pabloramesc/GimbalPlatform/pictures/3d_model.png

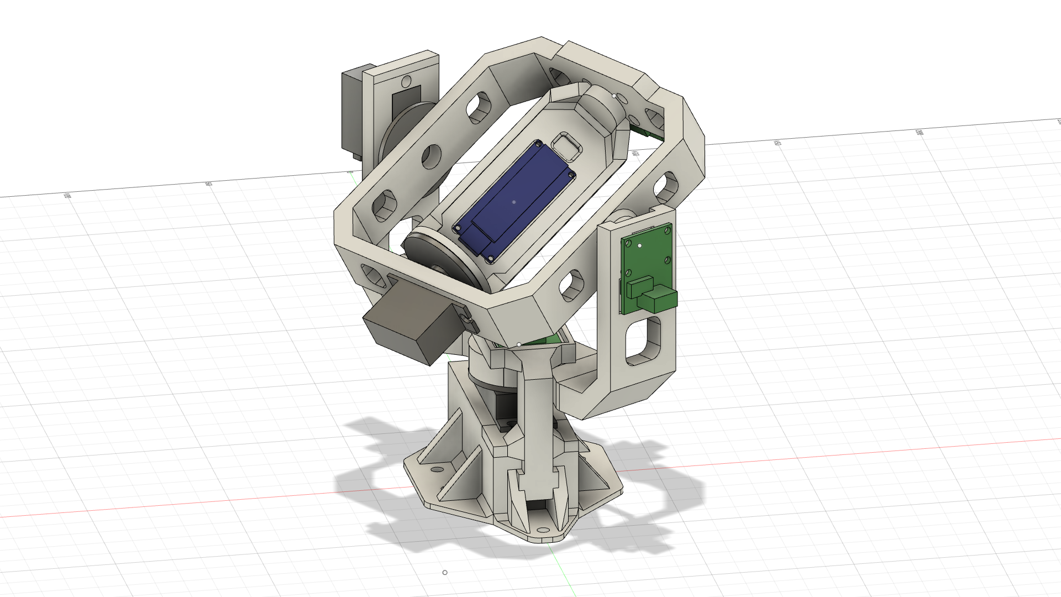
pictures/3d_model.png
