pabloramesc/GimbalPlatform/pictures/ble33_axis.png

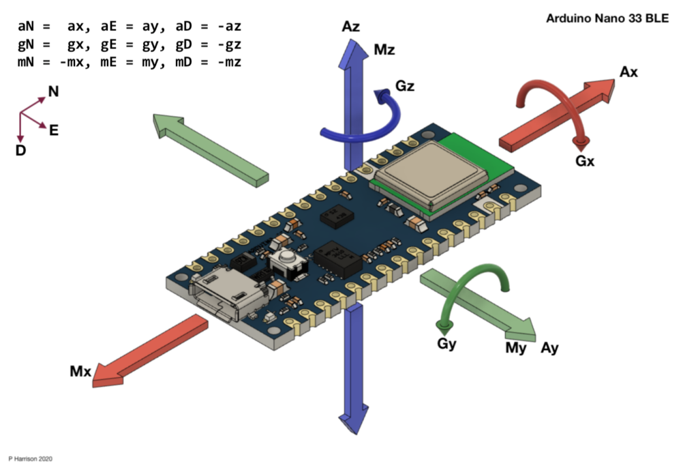
pictures/ble33_axis.png
