pabloramesc/GimbalPlatform/pictures/err_fast.png

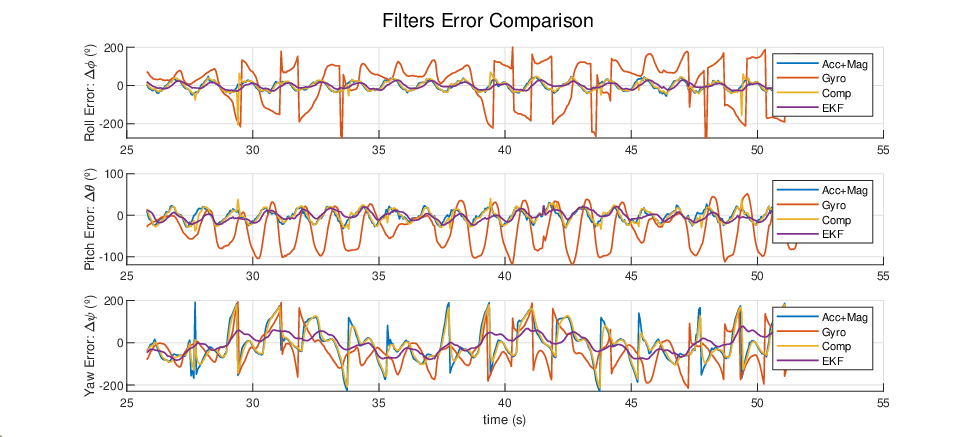
pictures/err_fast.png
