pabloramesc/GimbalPlatform/pictures/gimbal_axis.jpg

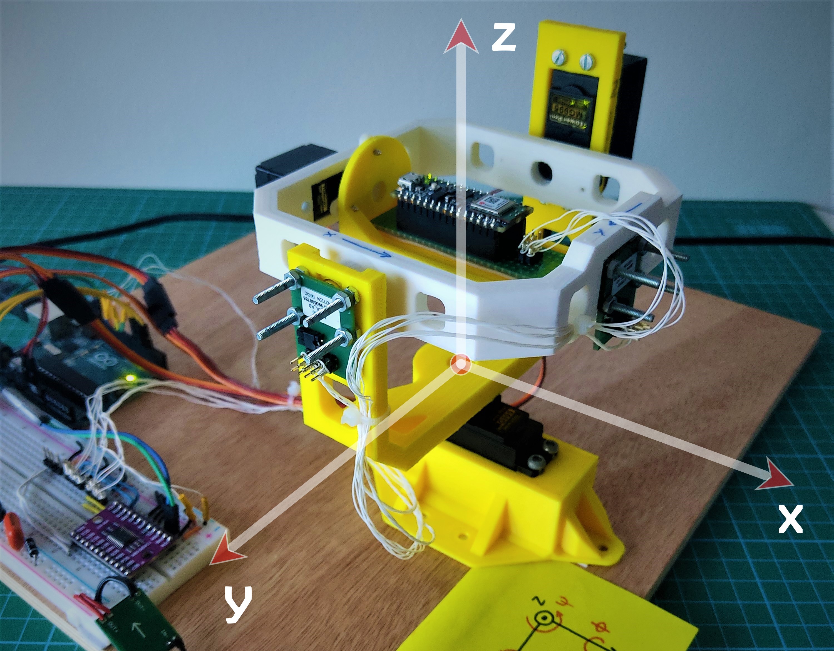
pictures/gimbal_axis.jpg
