pabloramesc/GimbalPlatform/pictures/sectionXY.png

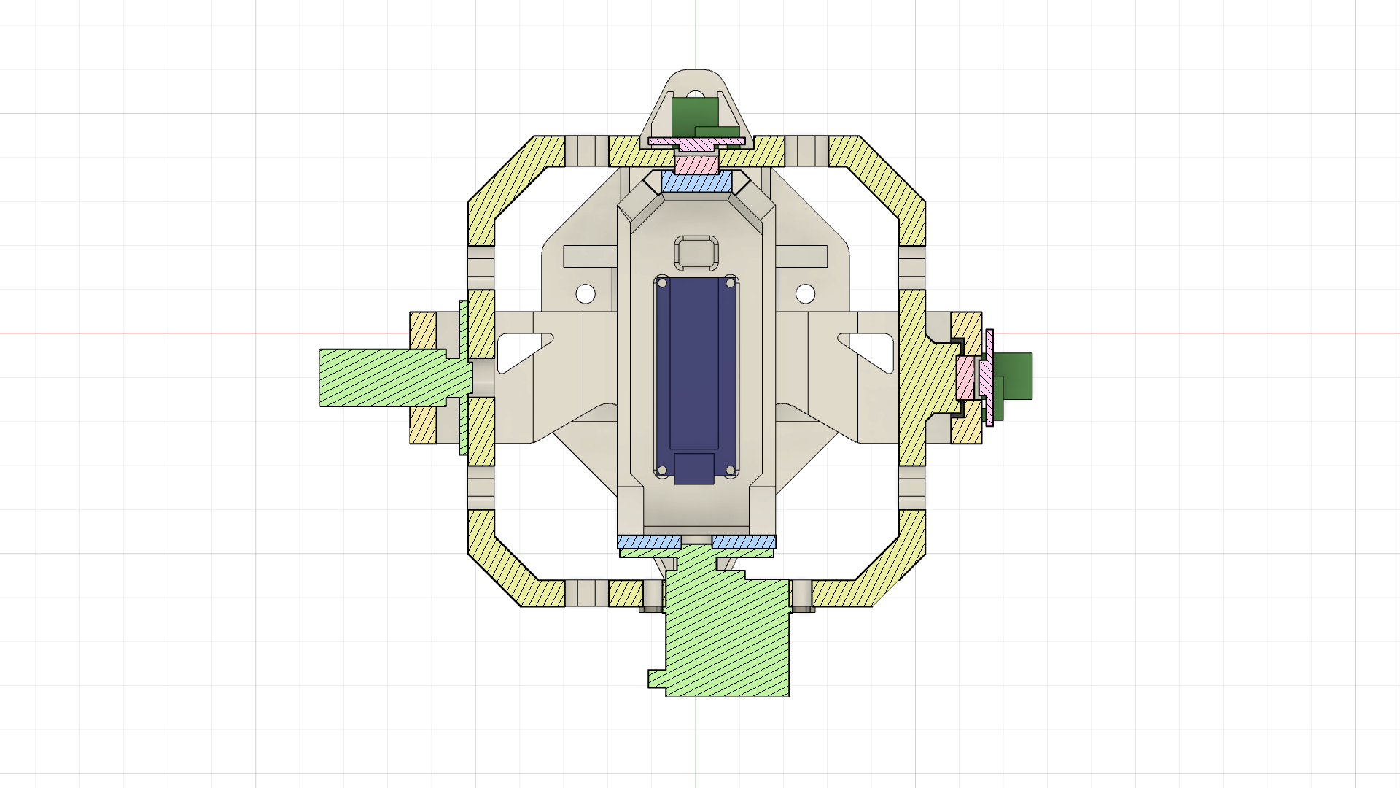
pictures/sectionXY.png
