pabloramesc/GimbalPlatform/pictures/sectionXZ.png

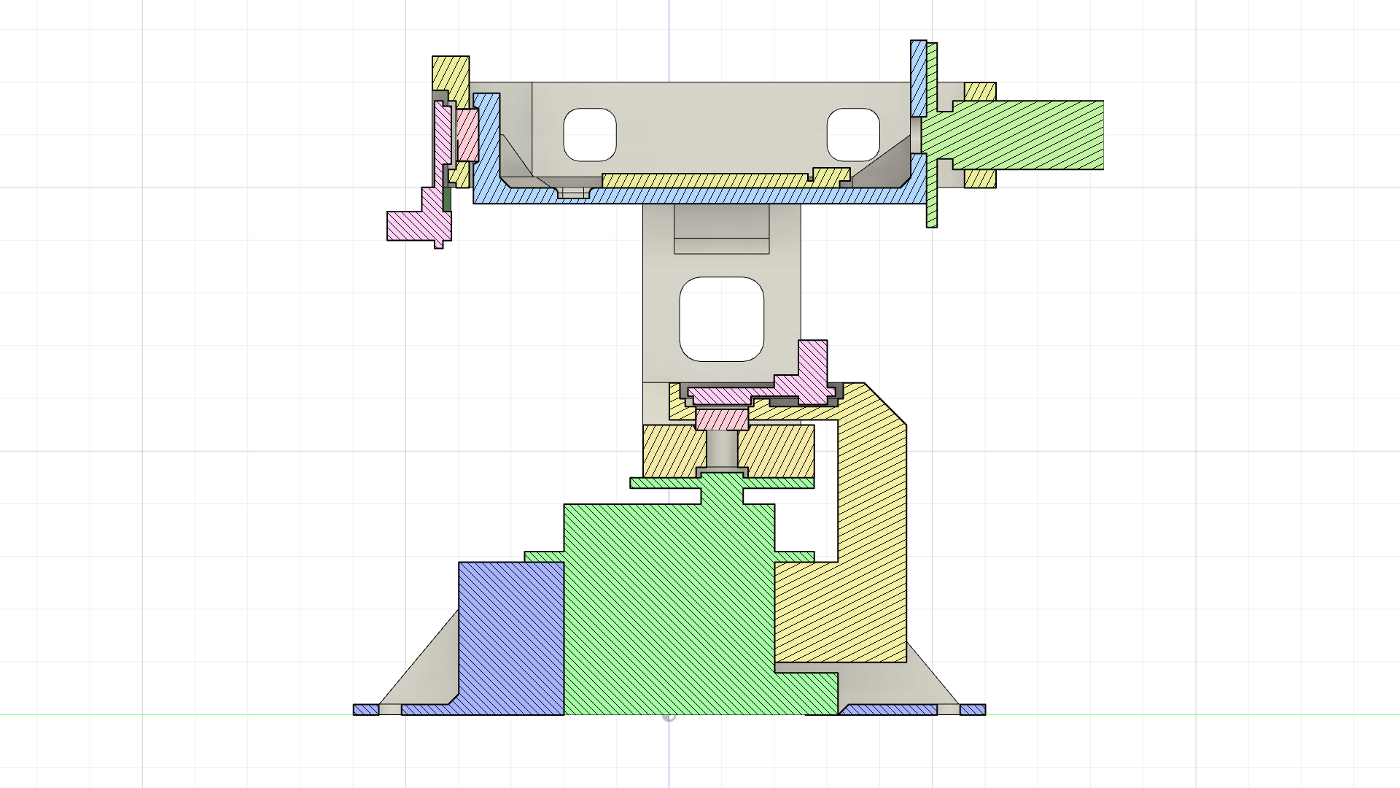
pictures/sectionXZ.png
