pabloramesc/GimbalPlatform/pictures/sectionYZ.png

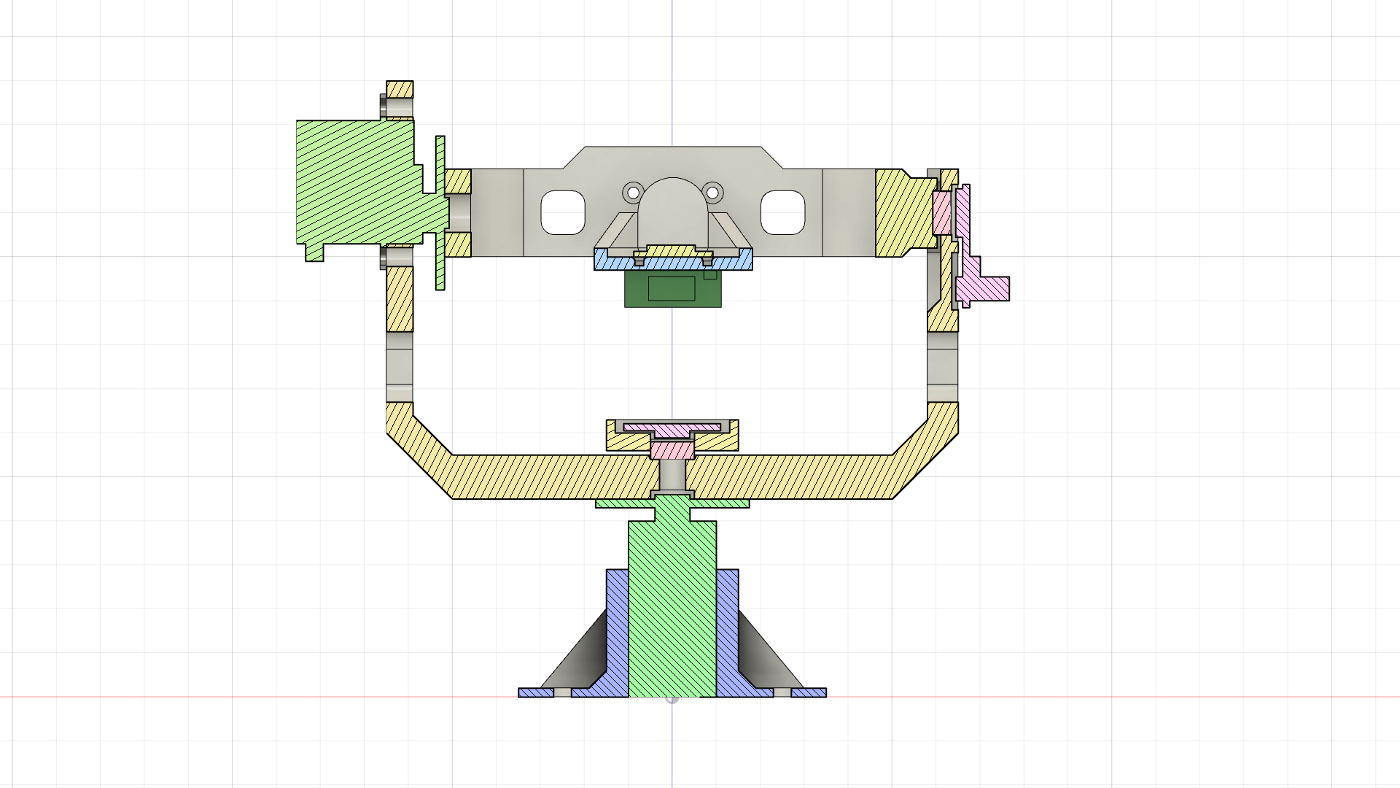
pictures/sectionYZ.png
