pabloramesc/GimbalPlatform/pictures/step01.png

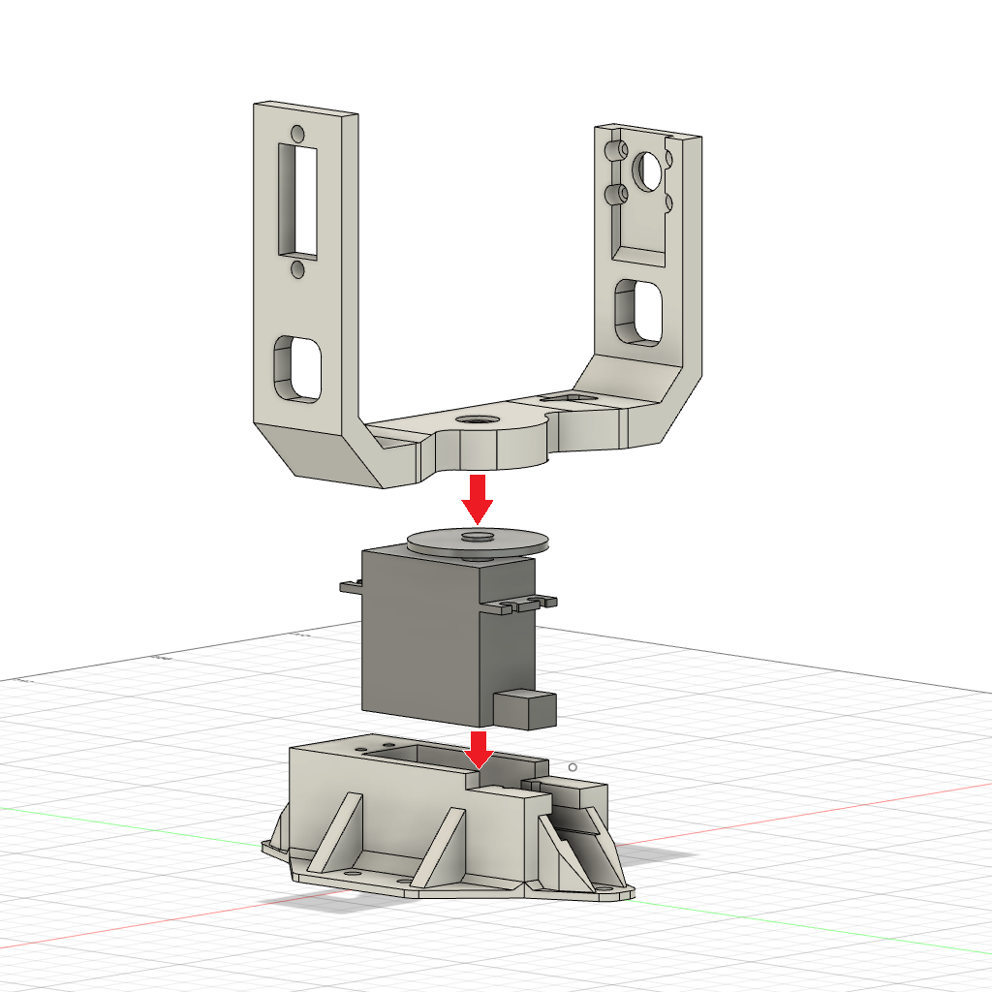
pictures/step01.png
