pabloramesc/GimbalPlatform/pictures/step02.png

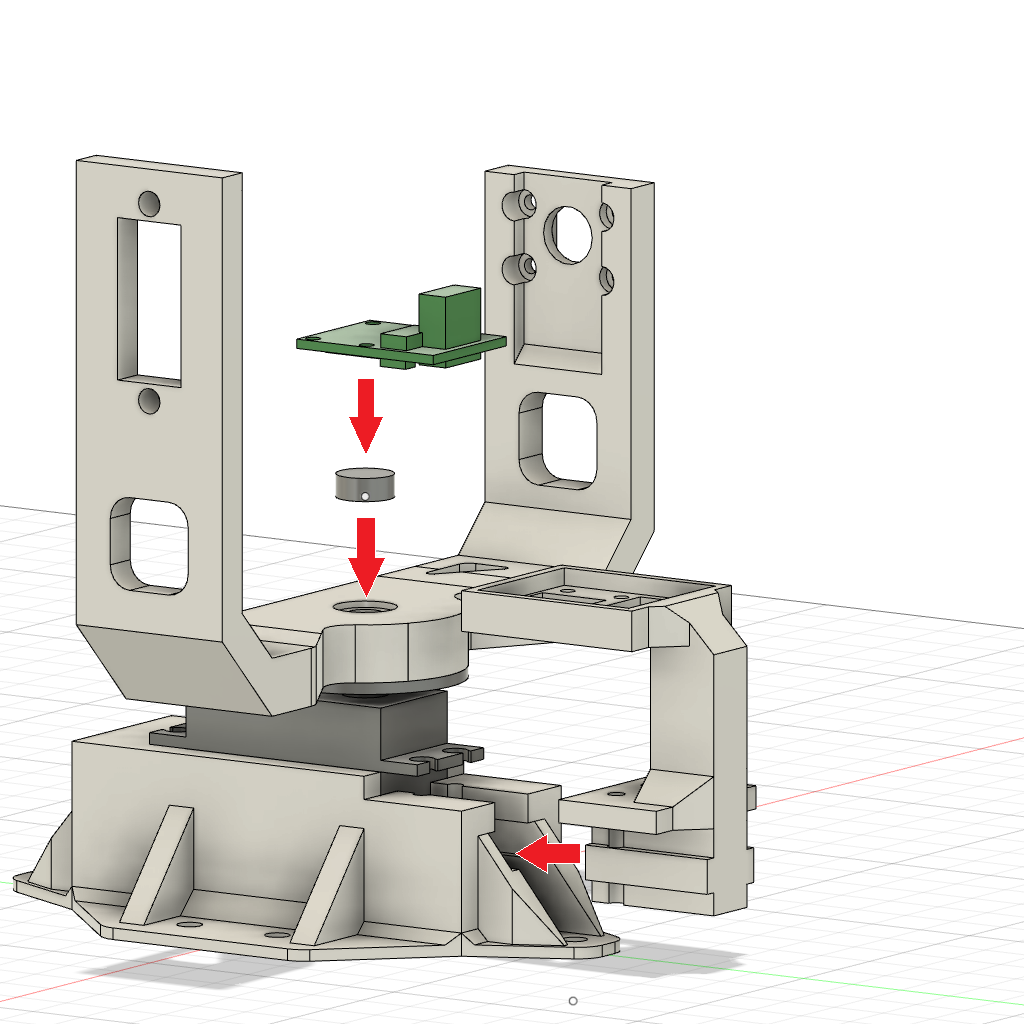
pictures/step02.png
