pabloramesc/GimbalPlatform/pictures/step03.png

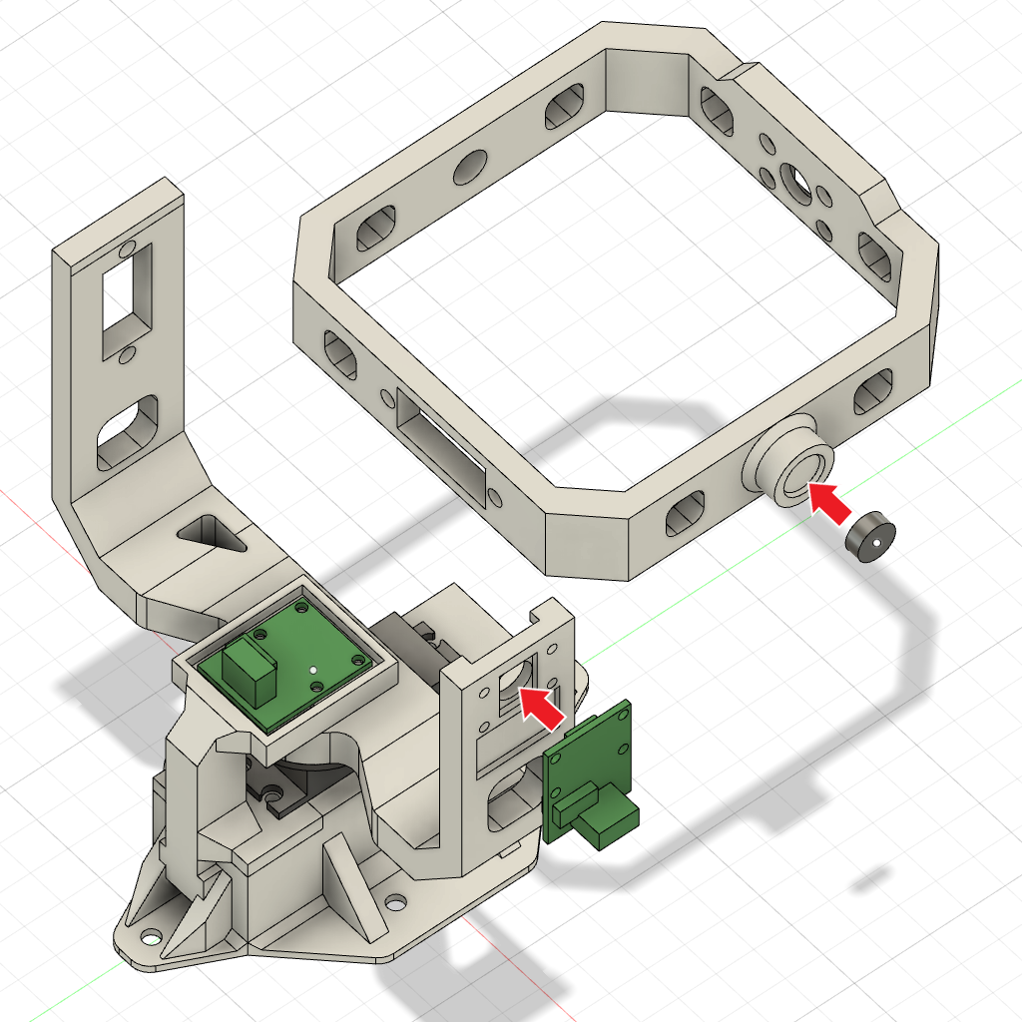
pictures/step03.png
