pabloramesc/GimbalPlatform/pictures/step04.png

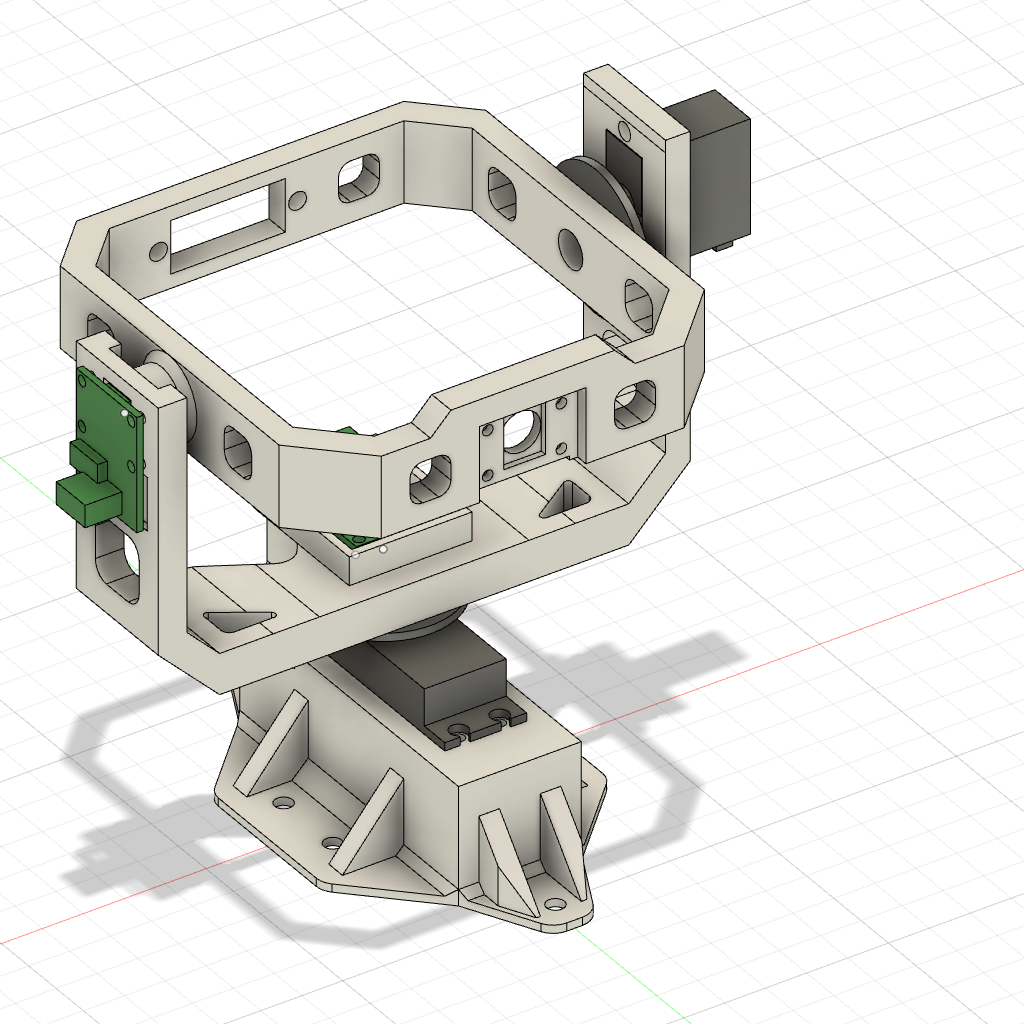
pictures/step04.png
