pabloramesc/GimbalPlatform/pictures/step05.png

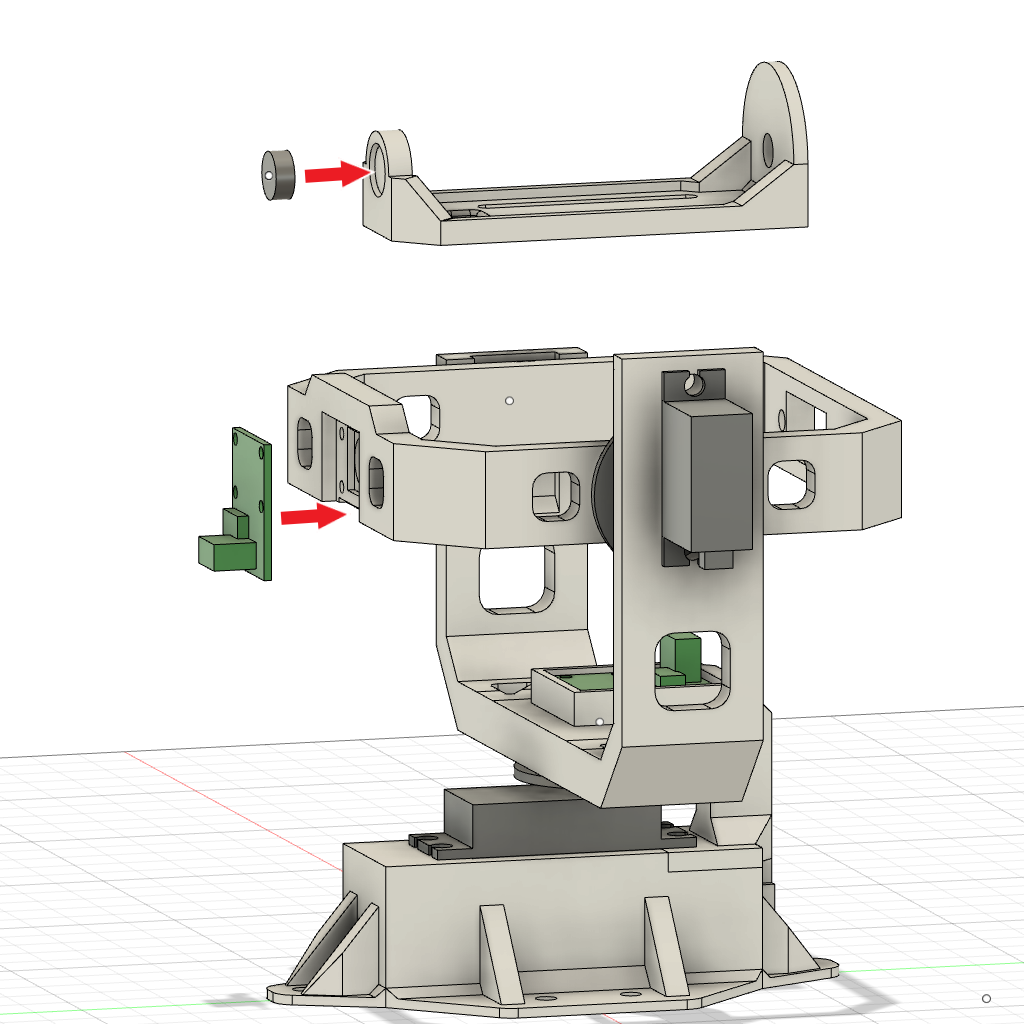
pictures/step05.png
