pabloramesc/GimbalPlatform/pictures/step06.png

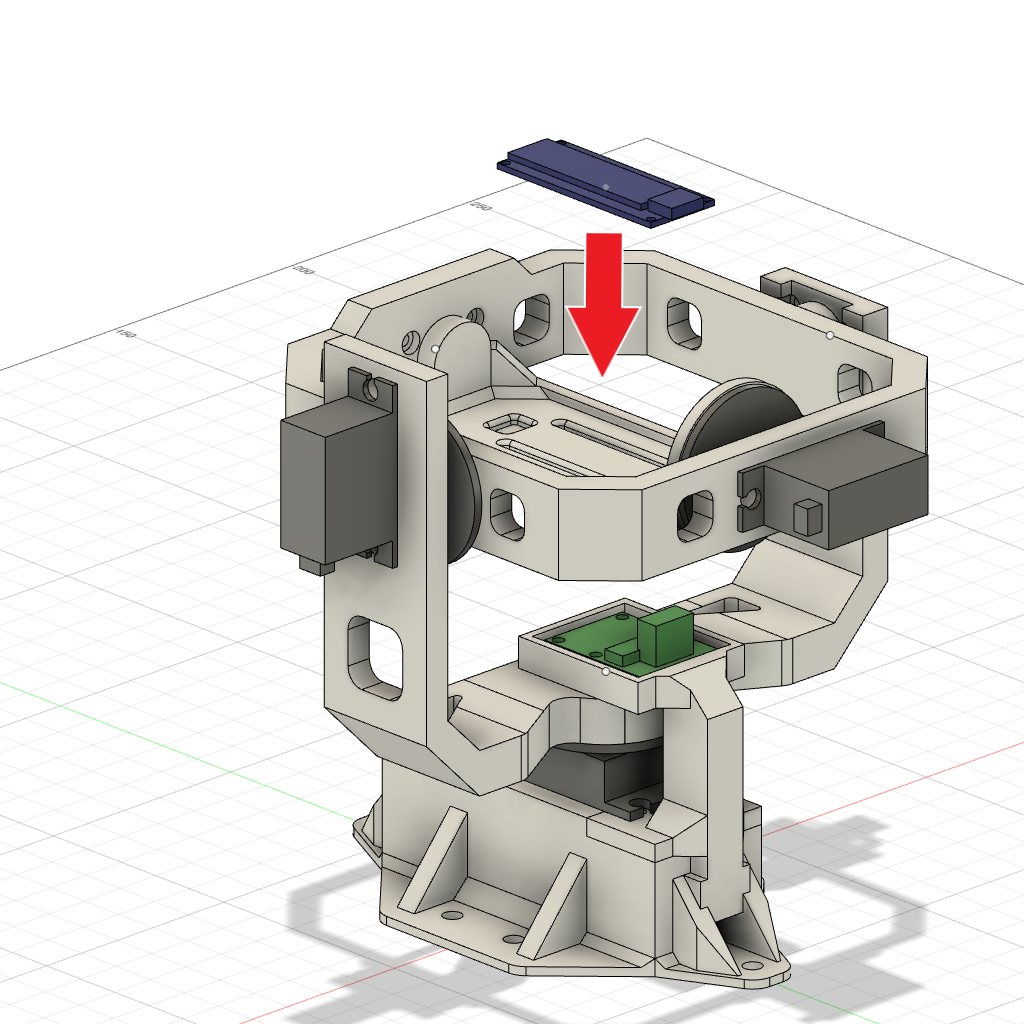
pictures/step06.png
