pabloramesc/GimbalPlatform/designs/drawing02_arm.pdf

A

A-A (1:1) 53 19

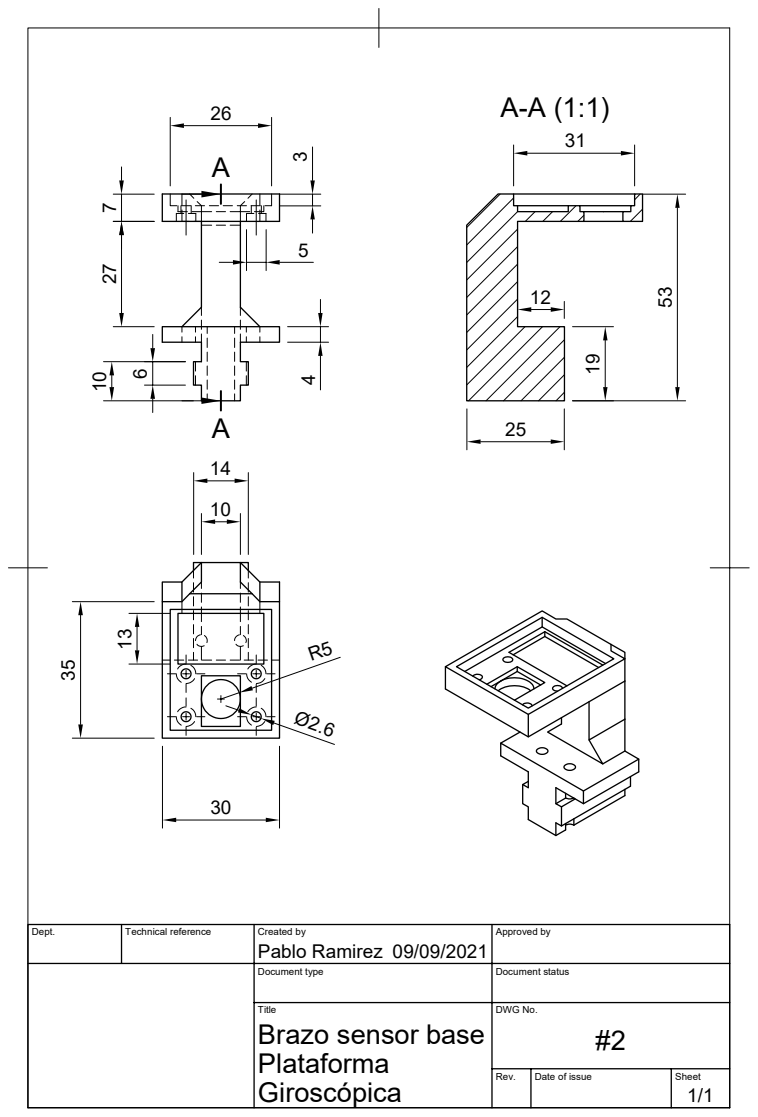
[picture p17: page 1]
Dept.; Technical reference; Created by; Approved by; Document type; Document status; Title; DWG No.; Rev.; Date of issue; Sheet; Giroscópica; Plataforma; Brazo sensor base; Pablo Ramirez
