pabloramesc/GimbalPlatform/designs/drawing01_base.pdf

A-A (1:1) | 20 40 20 20

10

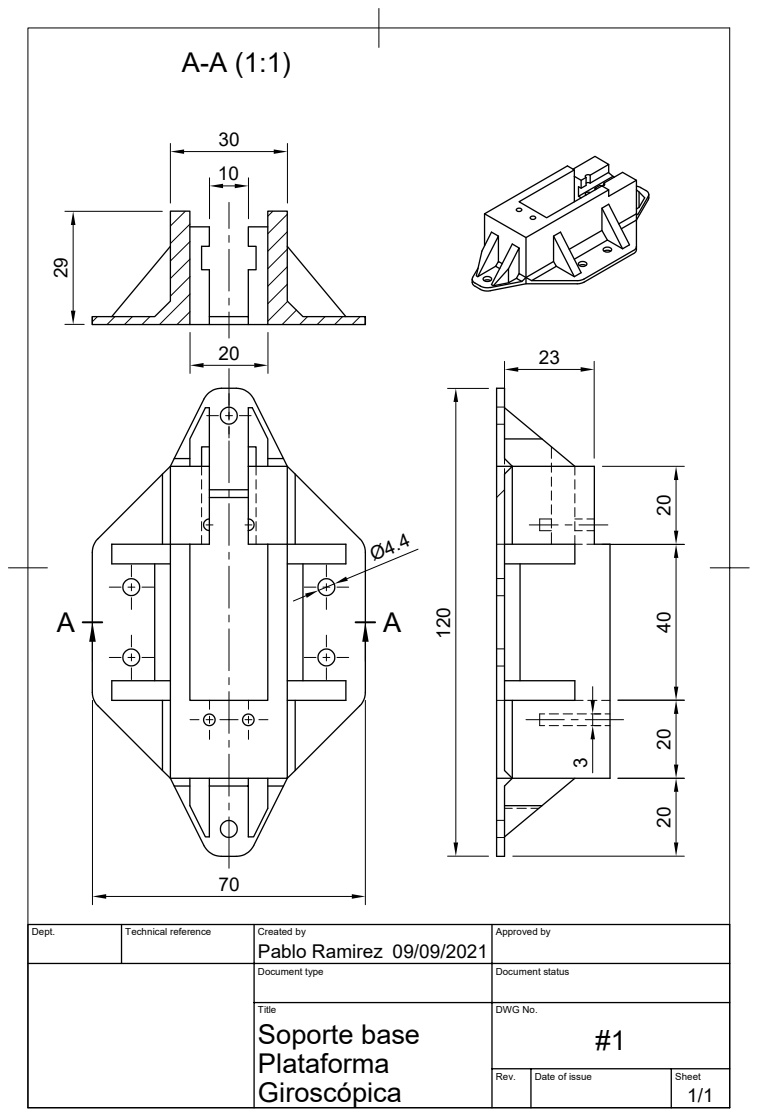
[picture p18: page 1]
Dept.; Technical reference; Created by; Approved by; Document type; Document status; Title; DWG No.; Rev.; Date of issue; Sheet; Giroscópica; Plataforma; Soporte base; Pablo Ramirez
