pabloramesc/GimbalPlatform/designs/drawing04_Ymount.pdf

28

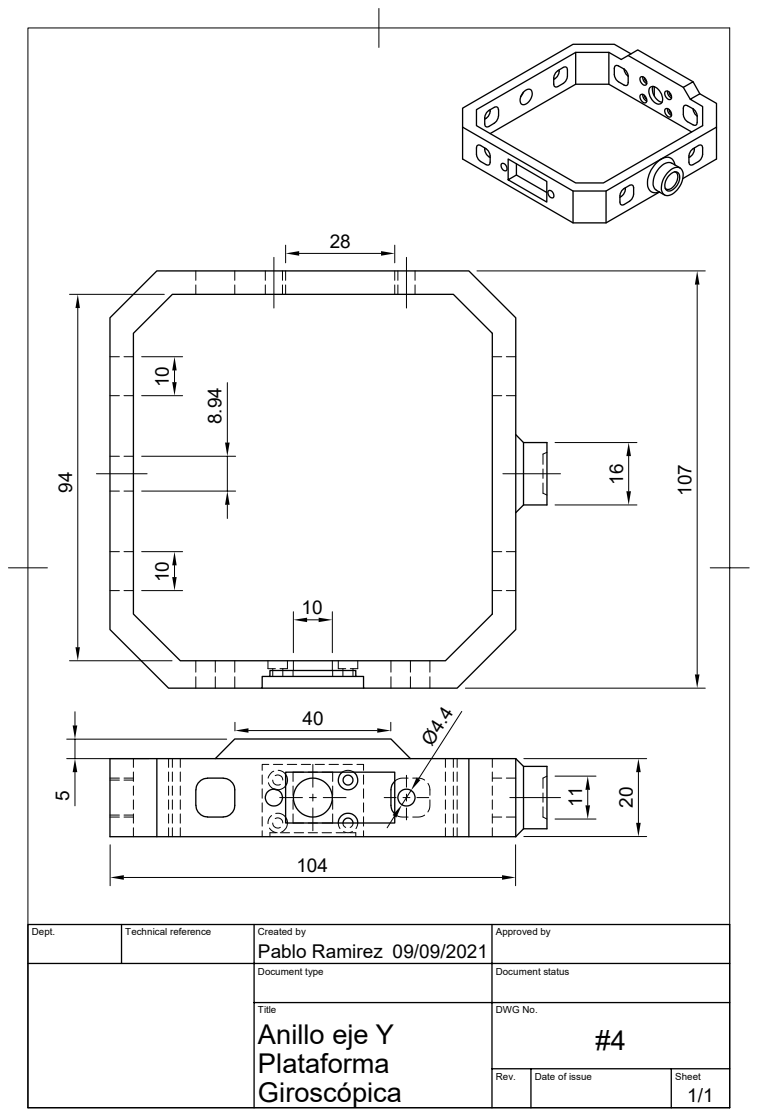
[picture p19: page 1]
Dept.; Technical reference; Created by; Approved by; Document type; Document status; Title; DWG No.; Rev.; Date of issue; Sheet; Giroscópica; Plataforma; Anillo eje Y; Pablo Ramirez
