pabloramesc/GimbalPlatform/designs/drawing05_Xmount.pdf

# 7 ⁸⁶ ¹³

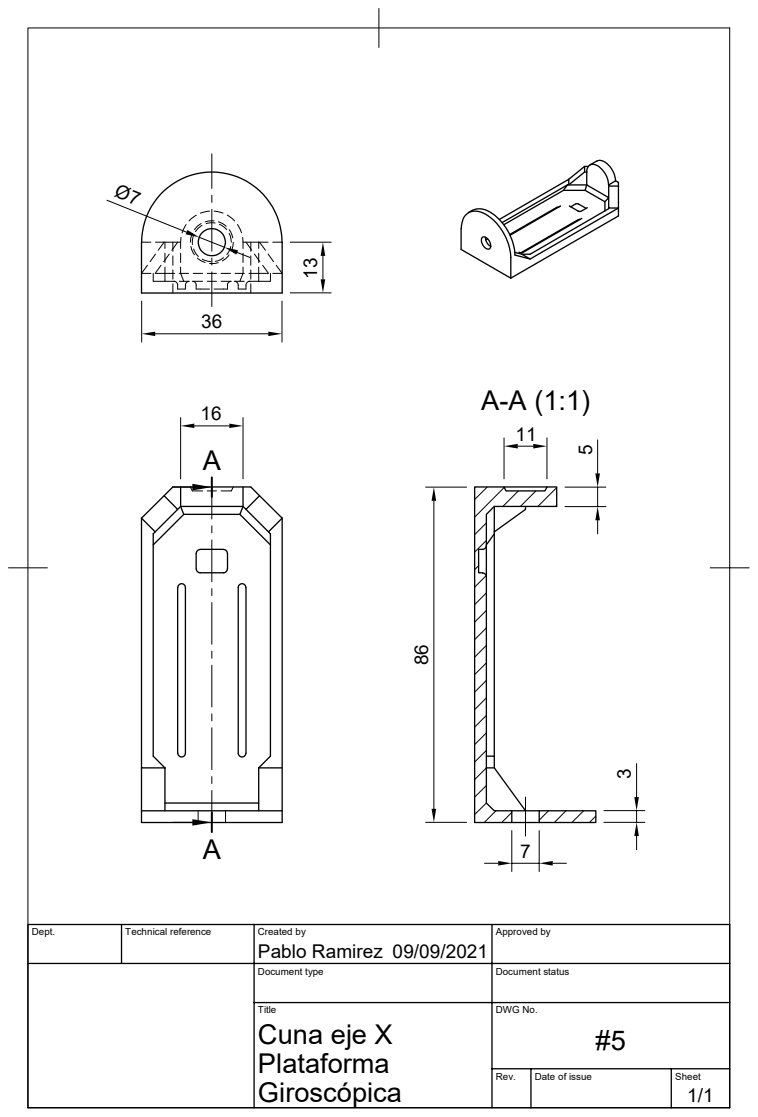
[picture p20: page 1]
Dept.; Technical reference; Created by; Approved by; Document type; Document status; Title; DWG No.; Rev.; Date of issue; Sheet; Giroscópica; Plataforma; Cuna eje X; Pablo Ramirez
