pabloramesc/GimbalPlatform/designs/electric_schematic.pdf

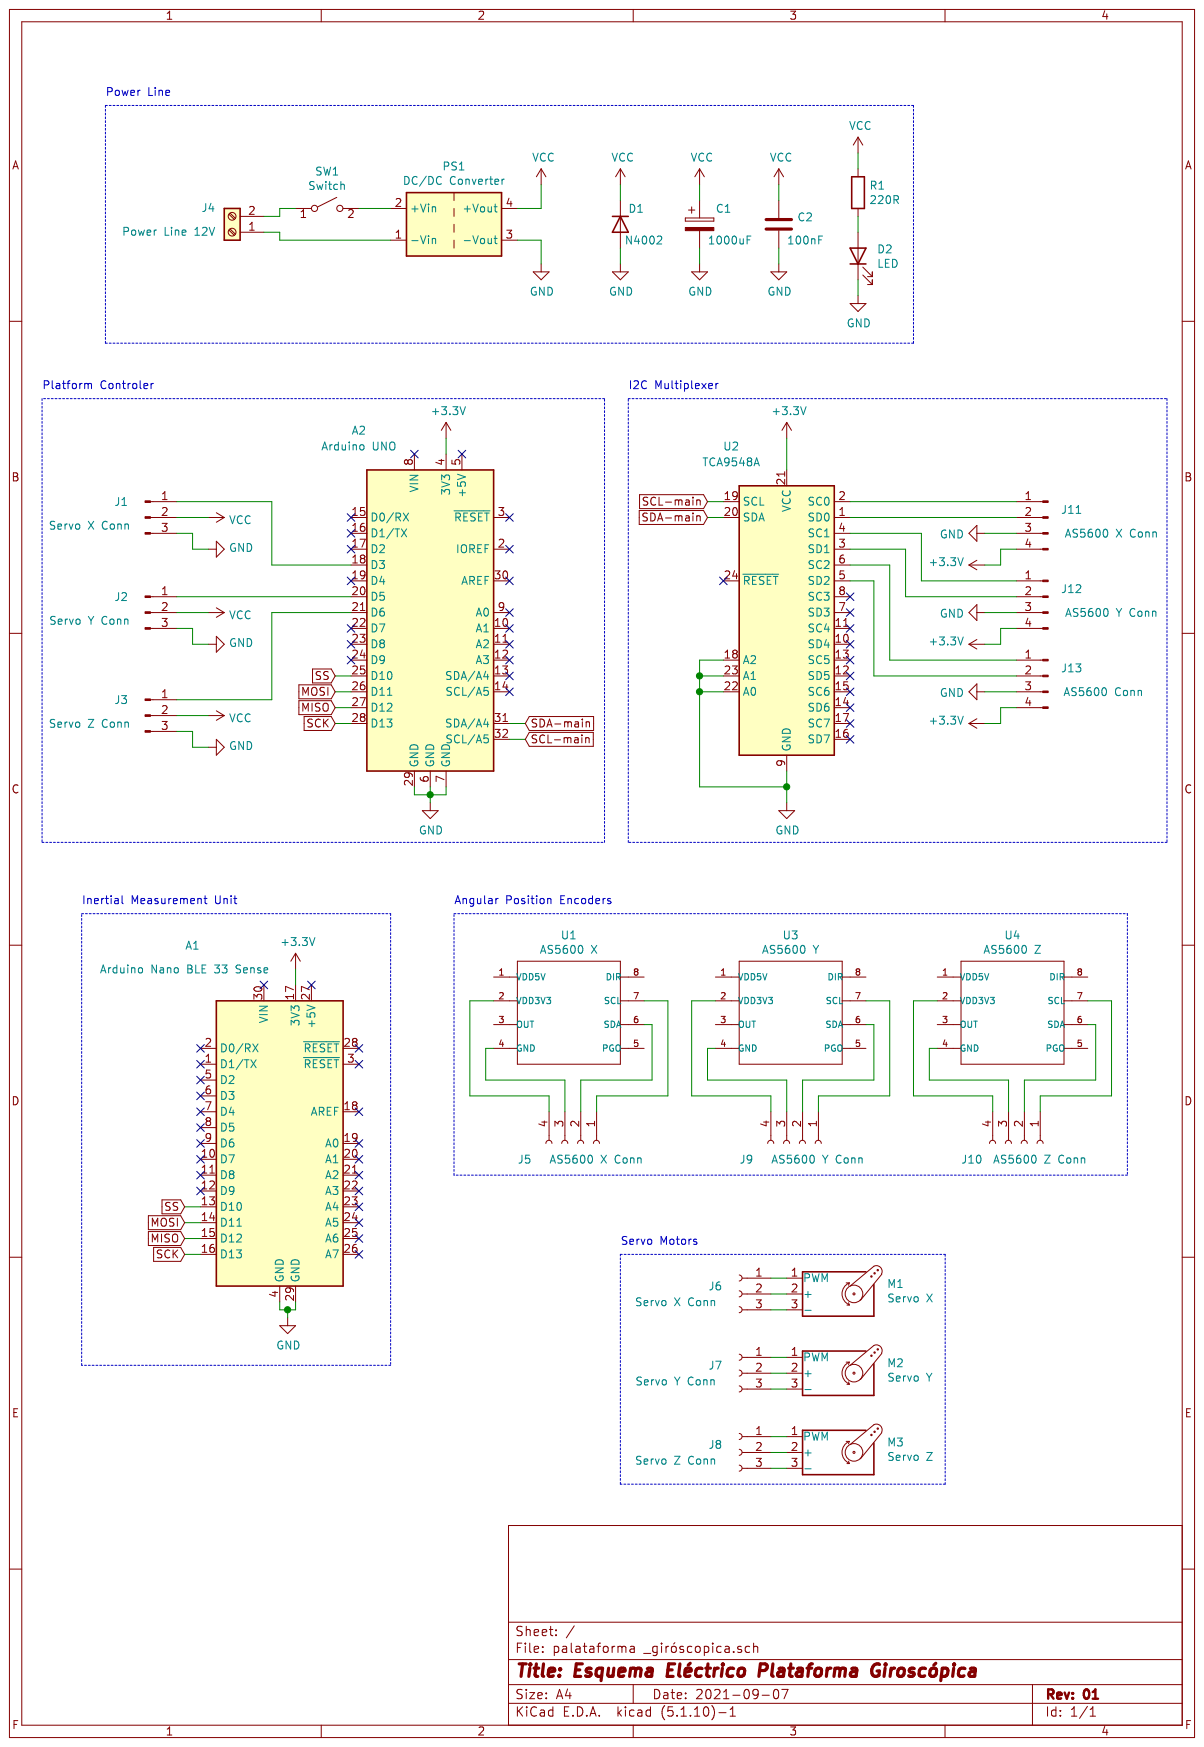
[picture p21: page 1]
