pabloramesc/GimbalPlatform/(commit log)

2021-09-13 Create arduino
2024-07-10 3d model drawings, electrical schematics and pictures added. README updated
2024-07-11 Assembly process and section pictures added. Minor README changes.
